Sir-Quickly/MeBroo/README.md

# #MeBroo
Erweiterungsboard für den RaspberryPi zur Brau-Automatisierung

Known Issues: - LEDs falsch angeschlossen, Handpatch notwendig
