Sir-Quickly/MeBroo/Stueckliste.xlsx

ID | Bezeichner | GehÃ¤use | StÃ¼ckzahl | Bezeichnung | Anbieter und Referenz
1 | D3,D2,D4,D5,D6,D1 | D_SOD-123 | 6 | 1N4148W | RND 1N4148W
2 | RV8,RV6,RV9,RV7,RV1,RV2,RV3,RV5,RV4,RV10 | Varistor_0805_2012Metric | 10 | Varistor | VC 0805-14
3 | R27,R25,R26,R24 | R_0805_2012Metric | 4 | 10R | SMD-0805 10,0
4 | R23,R22,R21,R20,R12,R11,R19 | R_0805_2012Metric | 7 | 0R | SMD-0805 0,00
5 | U1 | TE818_SwitchingRegulator_Module | 1 | TE818 | Ebay
6 | J5,J6,J7 | JST_XH_B04B-XH-AM_1x04_P2.50mm_Vertical | 3 | Conn_01x04 | JST XH4P ST
7 | Q2,Q7,Q8,Q6,Q5 | SOT-23 | 5 | BC848 | BC 848C INF
8 | C3,C5 | CP_EIA-3528-21_Kemet-B | 2 | 4u7/6V3 | TPS 3225 100/6,3
9 | R10,R2,R9,R7,R6 | R_0805_2012Metric | 5 | 2k2 | SMD-0805 2,20K
10 | R3,R5,R4,R8 | R_0805_2012Metric | 4 | 10k | SMD-0805 10,0K
11 | R1 | R_0805_2012Metric | 1 | 4k7 | SMD-0805 4,70K
12 | Q3,Q4 | SOT-23 | 2 | 2N7002 | 2N 7002KT1G ONS
13 | J1 | PinSocket_2x20_P2.54mm_Vertical | 1 | Conn_02x20_Odd_Even
14 | C2,C4,C6 | C_0805_2012Metric | 3 | 100n | KEM X7R0805 100N
15 | C1 | CP_EIA-6032-28_Kemet-C | 1 | 100u/16V | TPS 6032 100/16
16 | J3,J4 | JST_XH_B02B-XH-AM_1x02_P2.50mm_Vertical | 2 | Conn_01x02 | JST XH2P ST
17 | D7,D8,D9,D10 | LED_0805_2012Metric | 4 | green | OSO LGR971
18 | D11 | LED_0805_2012Metric | 1 | red | OSO LSR976
19 | D12 | LED_0805_2012Metric | 1 | orange | OSO LOR976
20 | R17,R16,R15,R14,R13 | R_0805_2012Metric | 5 | 1k2 | SMD-0805 4,70K
21 | R18 | R_0805_2012Metric | 1 | 4K7 | SMD-0805 4,70K
22 | BZ1 | Buzzer_12x9.5RM7.6 | 1 | Buzzer | VIS 3590
23 | Q1 | SOT-23 | 1 | IRLML6244 | IRLML 6244
24 | H4,H3,H2,H1 | MountingHole_2.7mm_M2.5_ISO7380 | 4 | MountingHole
25 | J2 | JST_XH_B03B-XH-AM_1x03_P2.50mm_Vertical | 1 | Conn_01x03 | JST XH3P ST
