Sir-Quickly/MeBroo/MeBroo.kicad_pcb

## KiCad design MeBroo.kicad_pcb (2020-06-02)

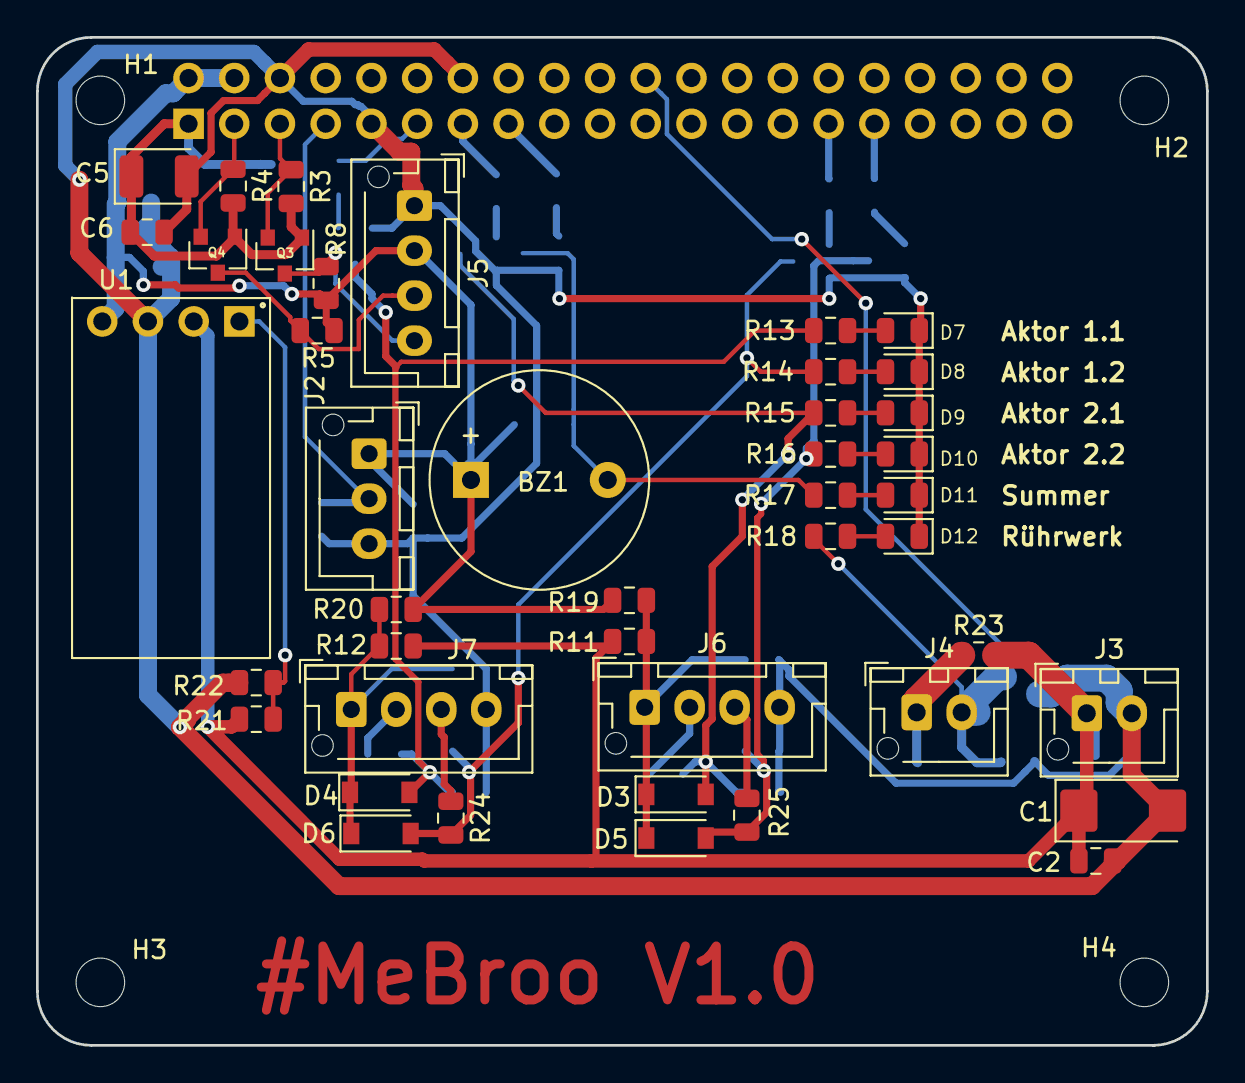
[picture p2: board MeBroo.kicad_pcb from above]

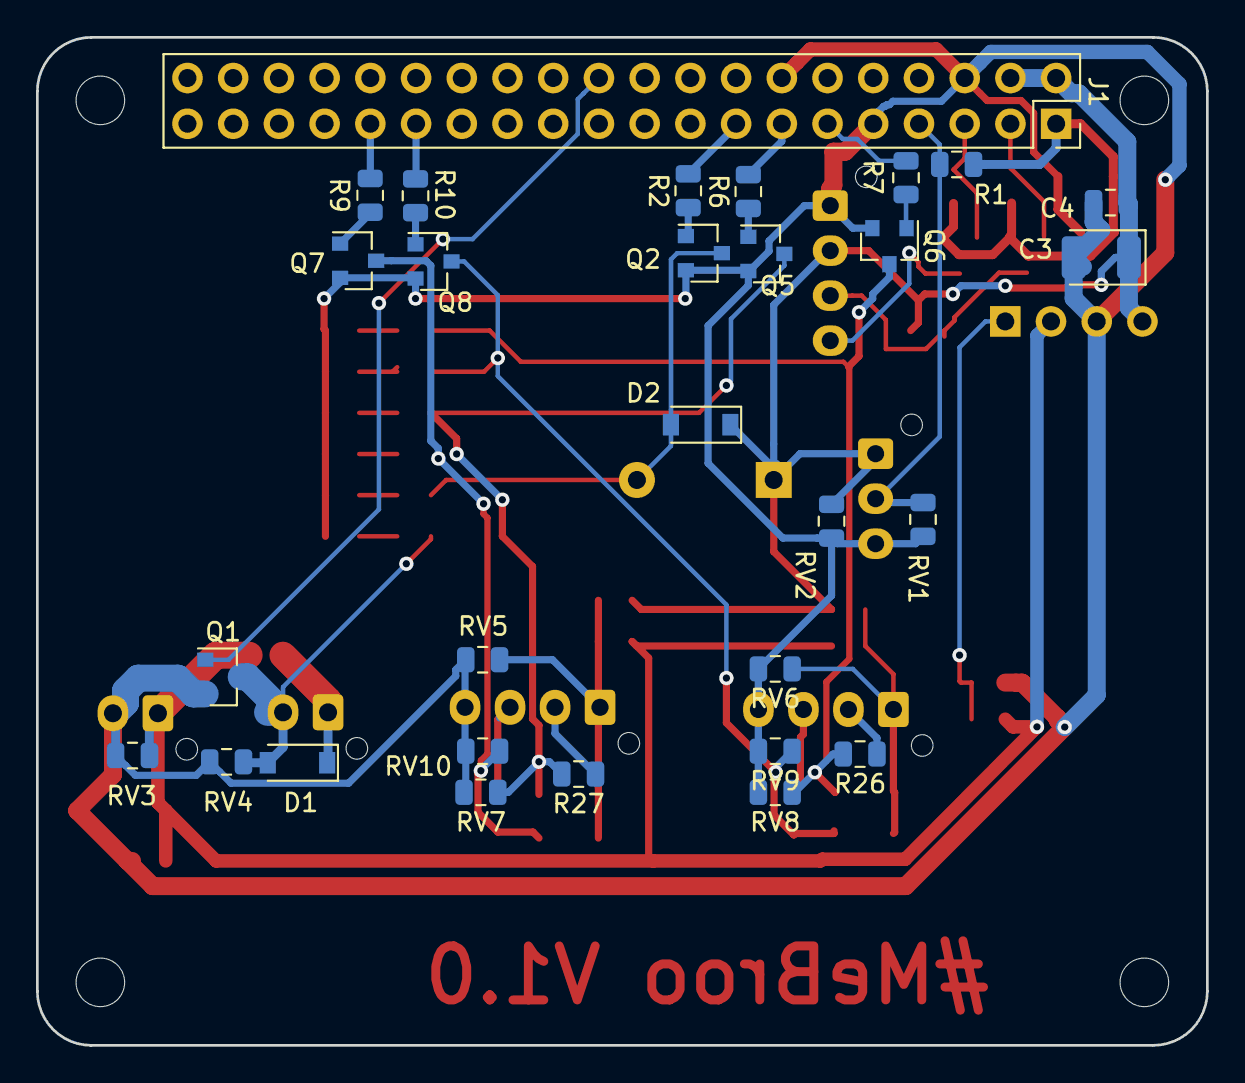
[picture p3: board MeBroo.kicad_pcb from below]

Board: 2 copper layers, 65.0 x 56.0 mm, 76 parts (29 on the bottom side), 40 nets.

Parts:
BZ1: Buzzer; Buzzer_12x9.5RM7.6
C1: CP; CP_EIA-6032-28_Kemet-C
C2, C4, C6: C; C_0805_2012Metric
C3, C5: CP; CP_EIA-3528-21_Kemet-B
D1, D2, D3, D4, D5, D6: 1N4148W; D_SOD-123
D7, D8, D9, D10, D11, D12: green; LED_0805_2012Metric
H1, H2, H3, H4: MountingHole; MountingHole_2.7mm_M2.5_ISO7380
J1: Conn_02x20_Odd_Even; PinSocket_2x20_P2.54mm_Vertical
J2: Conn_01x03; JST_XH_B03B-XH-AM_1x03_P2.50mm_Vertical
J3, J4: Conn_01x02; JST_XH_B02B-XH-AM_1x02_P2.50mm_Vertical
J5, J6, J7: Conn_01x04; JST_XH_B04B-XH-AM_1x04_P2.50mm_Vertical
Q1: IRLML6244; SOT-23
Q2, Q5, Q6, Q7, Q8: BC848; SOT-23
Q3, Q4: 2N7002; SOT-23
R1: 4k7; R_0805_2012Metric
R2, R6, R7, R9, R10, R11, R13, R14, R15, R16, R17, R18, R19, R24, R25, R26, R27: R; R_0805_2012Metric
R3, R4, R5, R8: 10k; R_0805_2012Metric
R12, R20, R21, R22, R23: 0R; R_0805_2012Metric
RV1, RV2, RV3, RV4, RV5, RV6, RV7, RV8, RV9, RV10: Varistor; Varistor_0805_2012Metric
U1: TE818; TE818_SwitchingRegulator_Module

Connections:
+3V3: C5.1, C6.1, J1.1, J1.17, Q3.1, Q4.1, R1.2, R3.2, R4.2
+5V: BZ1.1, C3.1, C4.1, D2.1, J1.2, J1.4, J2.1, J5.2, R5.2, R8.2, R19.1, R20.1, RV2.1, U1.4
+12V: C1.1, C2.1, J3.1, R11.1, R12.1, R21.2, R23.2, RV3.1, U1.2
/AKT_1_1: D4.2, Q6.3, R13.1, R26.2, RV8.1
/AKT_1_2: D6.2, Q8.3, R14.1, R24.2, RV9.1
/AKT_2_1: D3.2, Q5.3, R15.1, R27.2, RV7.1
/AKT_2_2: D5.2, Q7.3, R16.1, R25.2, RV10.1
/BUZZER: BZ1.2, D2.2, Q2.3, R17.1
/GPIO_4: J1.7, J2.2, R1.1, RV1.1
/GPIO_5: J1.29, R10.2
/GPIO_6: J1.31, R9.2
/GPIO_17: J1.11, R7.2
/GPIO_22: J1.15, R2.2
/GPIO_25: J1.22, Q1.1
/GPIO_27: J1.13, R6.2
/SCL: J1.5, Q3.2, R3.1
/SCL_5V: J5.4, Q3.3, R8.1
/SDA: J1.3, Q4.2, R4.1
/SDA_5V: J5.3, Q4.3, R5.1
/STIRRER: D1.2, J4.2, Q1.3, R18.1, RV4.1
GND: C1.2, C2.2, C3.2, C4.2, C5.2, C6.2, D7.1, D8.1, D9.1, D10.1, D11.1, D12.1, J1.6, J1.9, J1.14, J1.20, J1.25, J1.30, J1.34, J1.39, J2.3, J3.2, J5.1, J6.4, J7.4, Q1.2, Q2.2, Q5.2, Q6.2, Q7.2, Q8.2, R22.2, RV1.2, RV2.2, RV3.2, RV4.2, RV5.2, RV6.2, RV7.2, RV8.2, RV9.2, RV10.2, U1.3
unnamed: D1.1, J4.1, R23.1
unnamed: D3.1, D5.1, J6.1, R11.2, R19.2, RV5.1
unnamed: D4.1, D6.1, J7.1, R12.2, R20.2, RV6.1
unnamed: D7.2, R13.2
unnamed: D8.2, R14.2
unnamed: D9.2, R15.2
unnamed: D10.2, R16.2
unnamed: D11.2, R17.2
unnamed: D12.2, R18.2
unnamed: J6.2, R27.1
unnamed: J6.3, R25.1
unnamed: J7.2, R26.1
unnamed: J7.3, R24.1
unnamed: Q2.1, R2.1
unnamed: Q5.1, R6.1
unnamed: Q6.1, R7.1
unnamed: Q7.1, R9.1
unnamed: Q8.1, R10.1
unnamed: R21.1, R22.1, U1.1
