Sir-Quickly/MeBroo/(commit log)

2020-06-02 initial commit of project to GitHub
    [MeBroo.kicad_pcb, MeBroo.sch]
2020-06-04 fixed libraryy issue
    [MeBroo.sch]
2020-06-04 some editorial housekeeping
    [MeBroo.sch]
2020-06-07 required Hanpatch and partlist added to repo
    [Stueckliste.xlsx]
